asmnoak/RDA5807_radio_ESP32C3_with_weekly_Schedule_round_LCD/extras/Irda5807proj2jpg.jpg

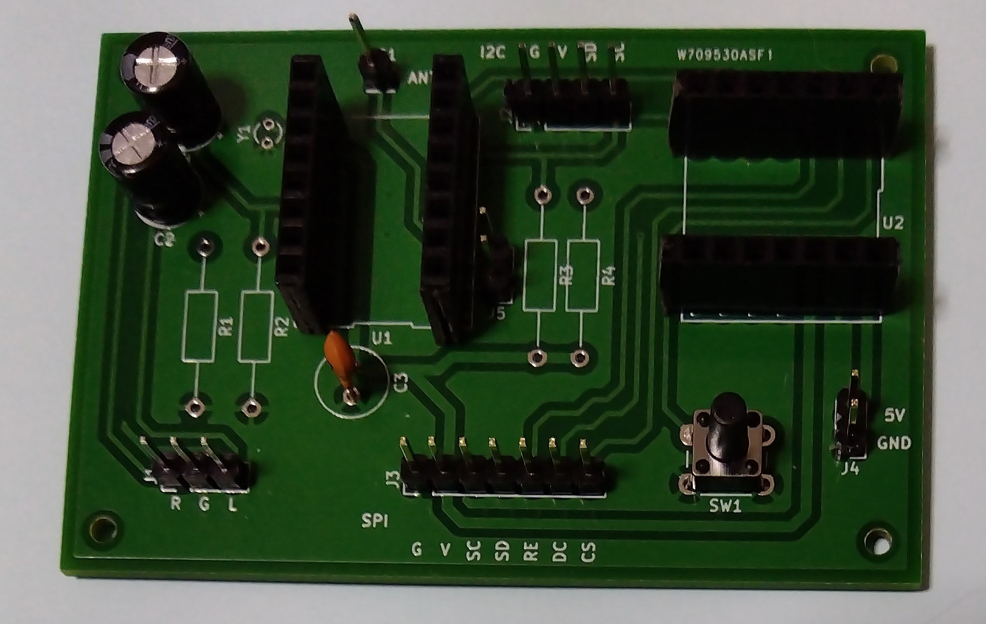
extras/Irda5807proj2jpg.jpg
