asmnoak/RDA5807_radio_ESP32C3_with_weekly_Schedule_round_LCD/extras/RDA5807_ESP32C3_haichi.png

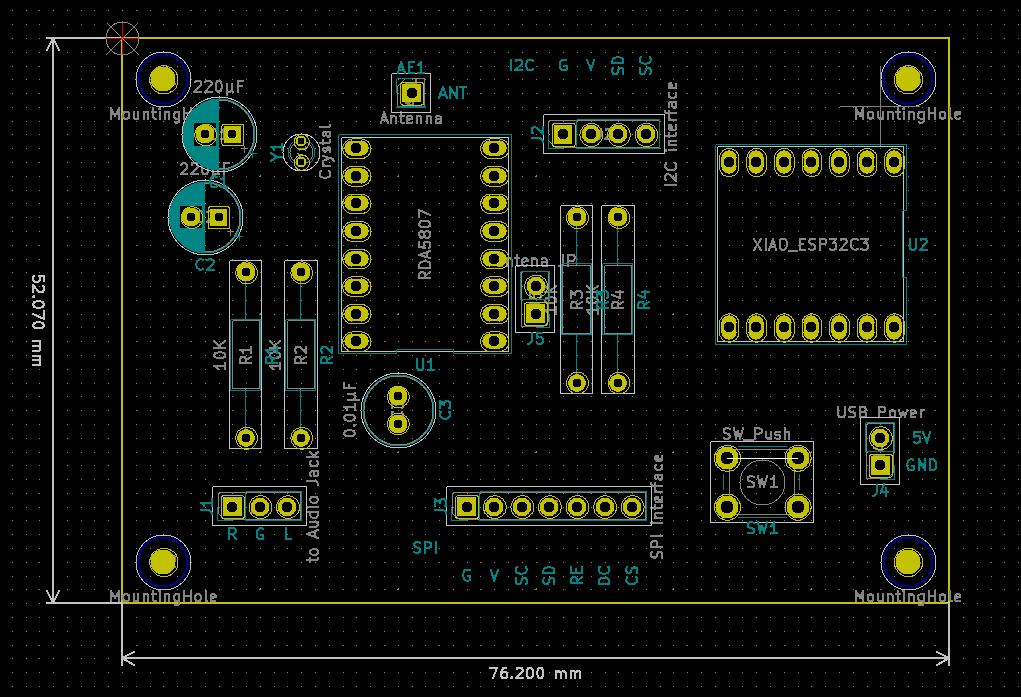
extras/RDA5807_ESP32C3_haichi.png
