asmnoak/RDA5807_radio_ESP32C3_with_weekly_Schedule_round_LCD/extras/rda5807_esp32c3_haisenzu.pdf

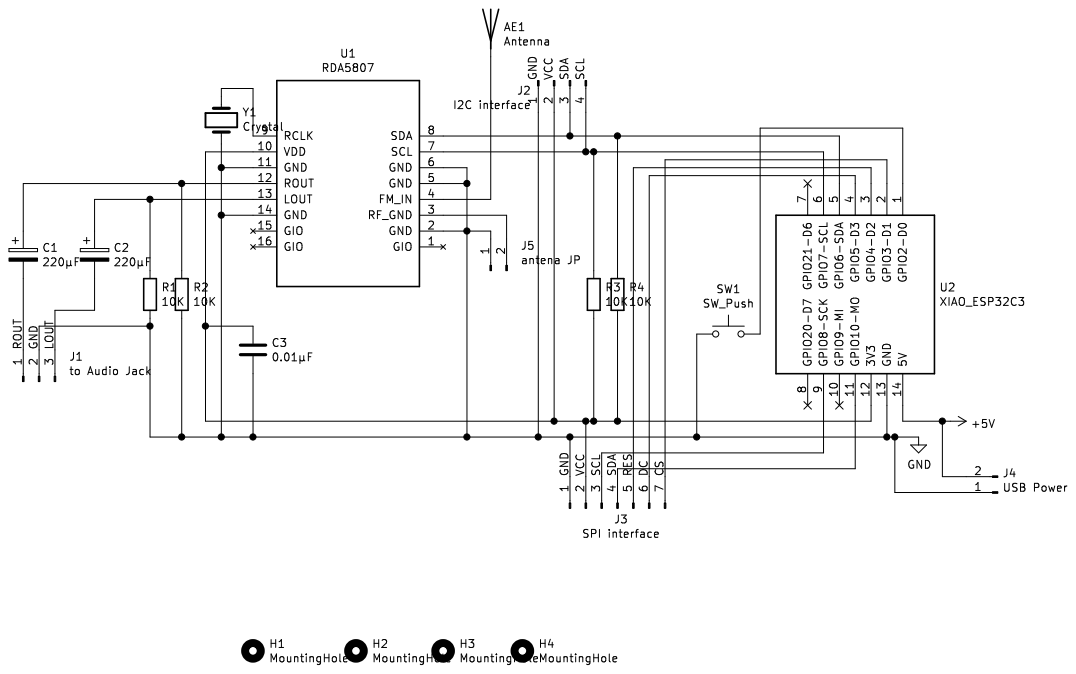
[picture p5: page 1]
