asmnoak/RDA5807_radio_ESP32C3_with_weekly_Schedule_round_LCD/(commit log)

2024-02-03 Add files via upload
    printed circuit board information
2024-02-03 Update README.md
    Add PCB information
